patrikpersson/speccyboot/concept.jpg

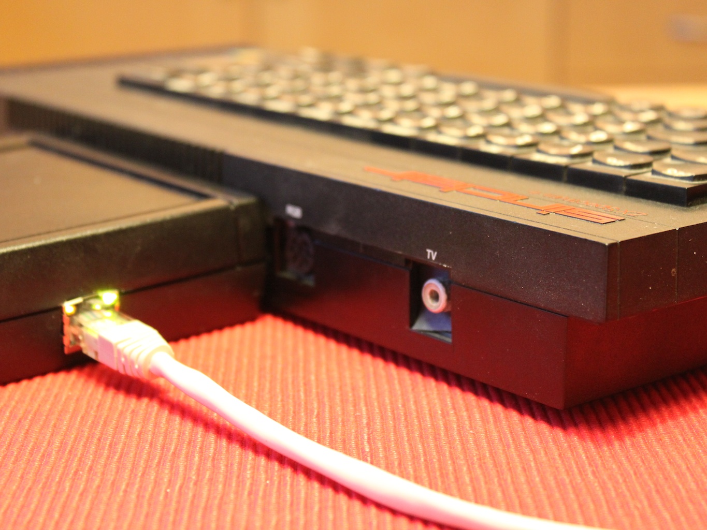
concept.jpg
