patrikpersson/speccyboot/demo-animated.png

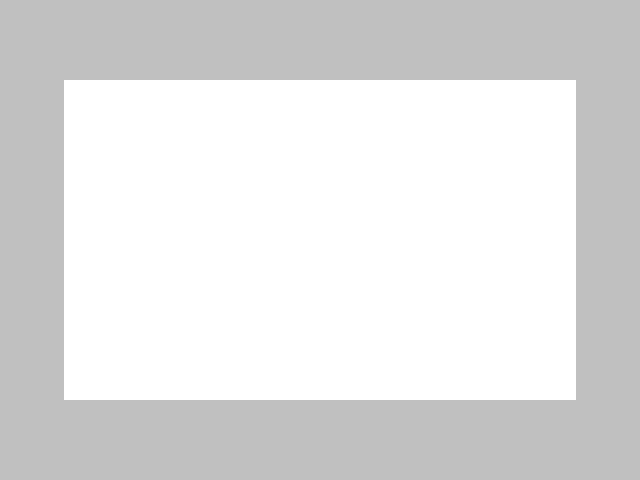
demo-animated.png
