patrikpersson/speccyboot/demo.png

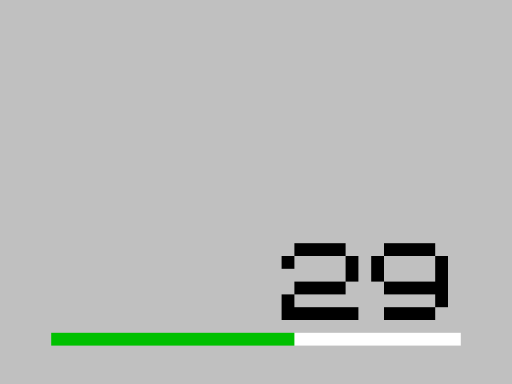
demo.png
