patrikpersson/speccyboot/fuse.png

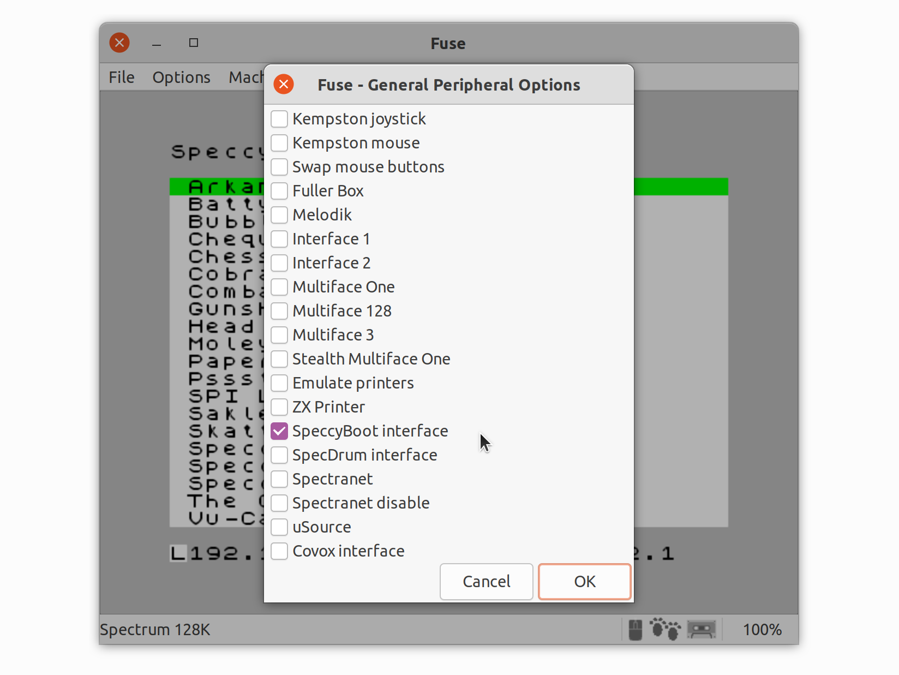
fuse.png
