patrikpersson/speccyboot/hardware.png

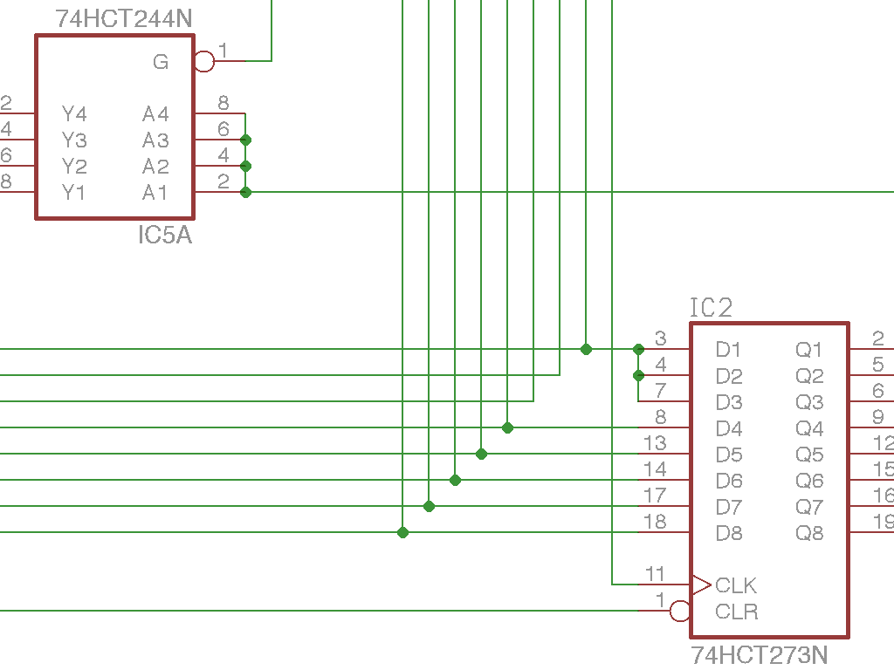
hardware.png
