patrikpersson/speccyboot/schematic.png

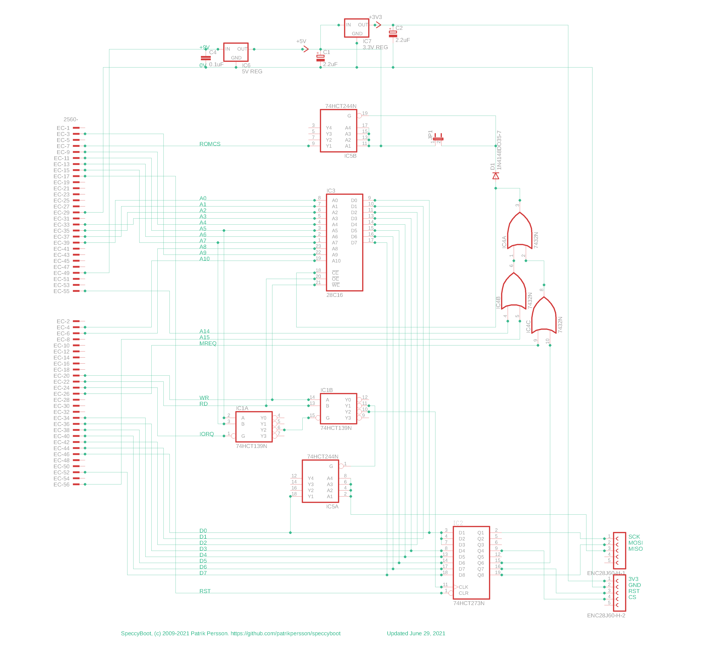
schematic.png
