patrikpersson/speccyboot/speccyboot.sch

## EAGLE design speccyboot.sch (2021-06-29)

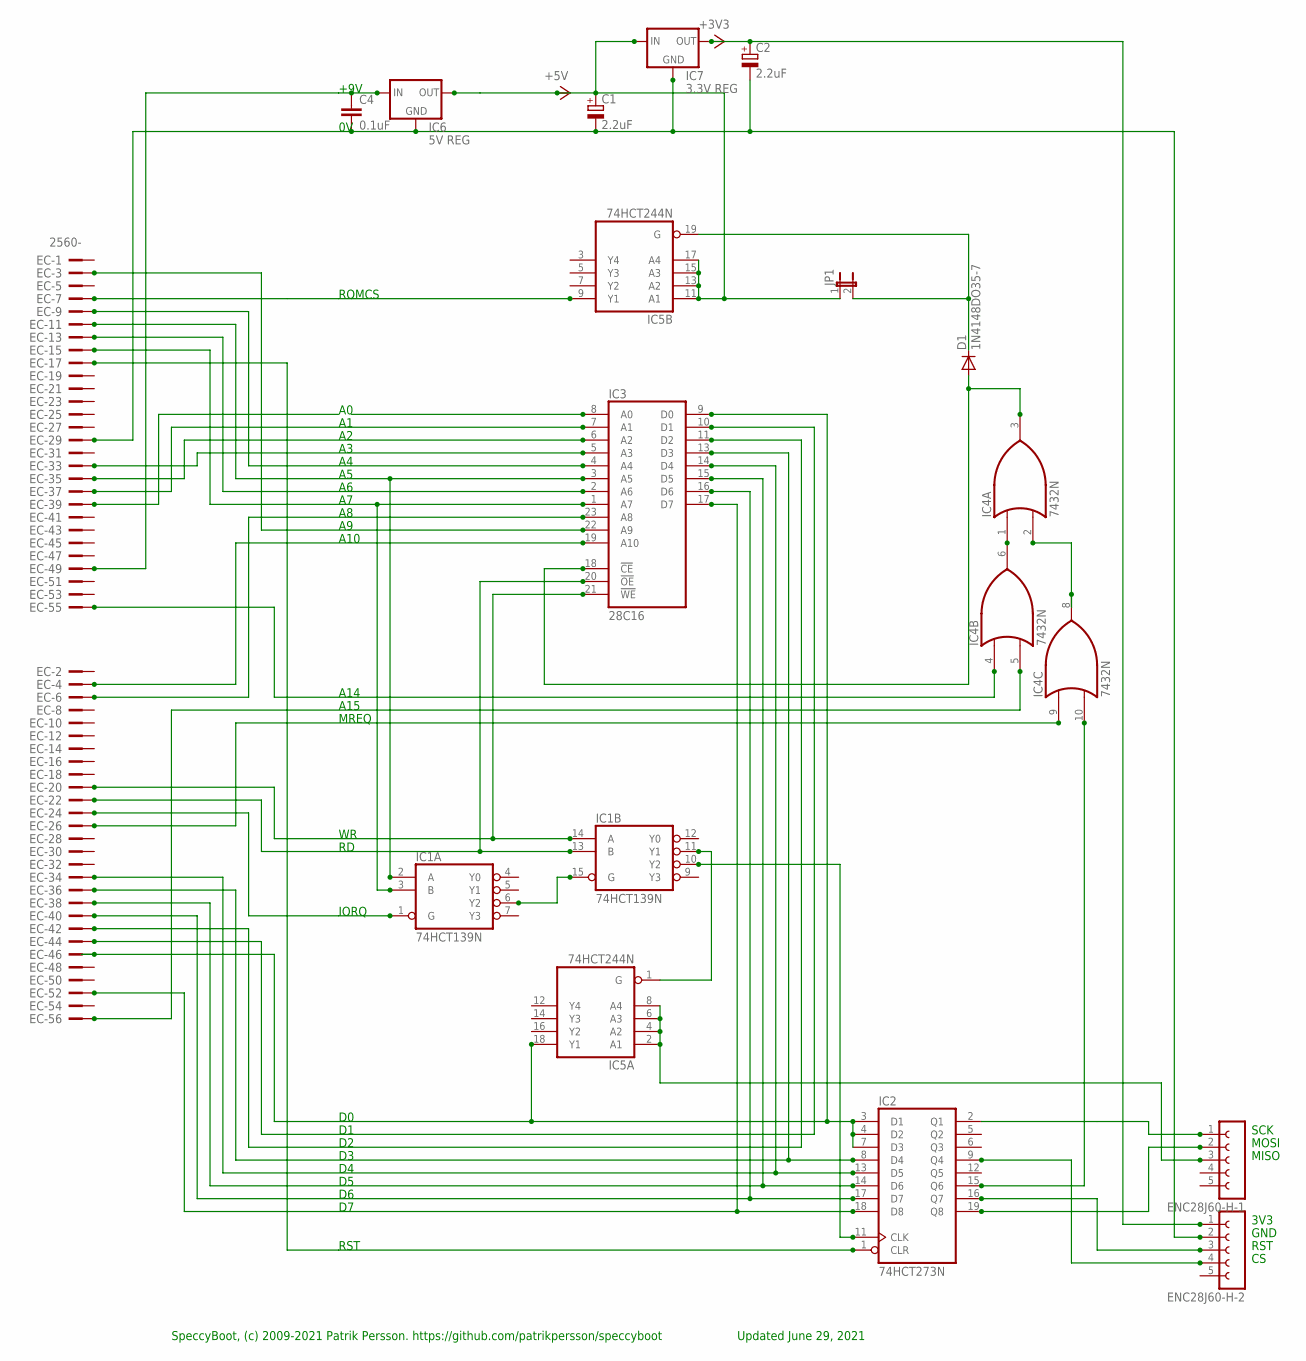
[picture p9: schematic speccyboot.sch]

Parts:
C1, C2: 2.2uF; E1,8-4
C4: 0.1uF; C025-024X044
D1: 1N4148DO35-7; DO35-7
EC: 2560-; PAK100/2500-60
ENC28J60-H-1, ENC28J60-H-2: FE05-1
IC1: 74HCT139N; DIL16
IC2: 74HCT273N; DIL20
IC3: 28C16; DIL24
IC4: 7432N; DIL14
IC5: 74HCT244N; DIL20
IC6: 5V REG; 78XXL
IC7: 3.3V REG; 78XXL
JP1: JP1E; JP1

Connections:
+3V3: C2.+, ENC28J60-H-2.1, IC7.OUT
unnamed: D1.A, IC3.18 (!CE), IC4.3 (O)
unnamed: EC.17, IC2.1 (CLR)
unnamed: EC.52, IC2.18 (D8), IC3.17 (D7), IC4.8 (O)
unnamed: ENC28J60-H-1.3, IC5.2 (A1), IC5.4 (A2), IC5.6 (A3), IC5.8 (A4)
unnamed: EC.38, IC2.14 (D6), IC3.15 (D5)
unnamed: EC.34, IC2.13 (D5), IC3.14 (D4)
unnamed: EC.36, IC2.8 (D4), IC3.13 (D3)
unnamed: EC.40, IC2.17 (D7), IC3.16 (D6)
unnamed: EC.24, IC1.1 (G)
unnamed: EC.46, IC2.3 (D1), IC2.4 (D2), IC2.7 (D3), IC3.9 (D0), IC5.18 (Y1)
unnamed: IC1.10 (Y2), IC2.11 (CLK)
unnamed: ENC28J60-H-2.4, IC2.9 (Q4)
unnamed: ENC28J60-H-2.3, IC2.16 (Q7)
unnamed: EC.42, IC3.11 (D2)
unnamed: EC.44, IC3.10 (D1)
unnamed: EC.37, IC3.7 (A1)
unnamed: EC.35, IC3.6 (A2)
unnamed: EC.33, IC3.5 (A3)
unnamed: EC.9, IC3.4 (A4)
unnamed: EC.11, IC1.2 (A), IC3.3 (A5)
unnamed: EC.13, IC3.2 (A6)
unnamed: EC.15, IC1.3 (B), IC3.1 (A7)
unnamed: EC.6, IC3.23 (A8)
unnamed: EC.3, IC3.22 (A9)
unnamed: EC.4, IC3.19 (A10)
unnamed: ENC28J60-H-1.1, IC2.2 (Q1)
unnamed: ENC28J60-H-1.2, IC2.19 (Q8)
unnamed: C1.-, C2.-, C4.2, EC.29, ENC28J60-H-2.2, IC6.GND, IC7.GND
unnamed: IC1.6 (Y2), IC1.15 (G)
unnamed: EC.7, IC5.9 (Y1)
unnamed: D1.C, IC5.19 (G), JP1.2
unnamed: EC.20, IC1.14 (A), IC3.21 (!WE)
unnamed: IC1.11 (Y1), IC5.1 (G)
unnamed: C4.1, EC.49, IC6.IN
unnamed: EC.26, IC4.9 (I0)
unnamed: EC.55, IC4.4 (I0)
unnamed: IC4.1 (I0), IC4.6 (O)
unnamed: EC.56, IC4.5 (I1)
unnamed: IC2.15 (Q6), IC4.10 (I1)
unnamed: C1.+, IC5.11 (A1), IC5.13 (A2), IC5.15 (A3), IC5.17 (A4), IC7.IN, JP1.1
unnamed: EC.22, IC1.13 (B), IC3.20 (!OE)

Notes on the sheet:
RST
IORQ
A10
+9V
A14
A15
MREQ
ROMCS
SpeccyBoot, (c) 2009-2021 Patrik Persson. https://github.com/patrikpersson/speccyboot
MISO
MOSI
SCK
3V3
GND
Updated June 29, 2021
