patrikpersson/speccyboot/(commit log)

2009-04-07 fixed typos, changed enum to match hardware change
    [speccyboot.h]
2009-04-07 changed hard-wired address
2009-04-07 tuned SPI code, adapted to hardware changes
2009-04-08 fixed typo in license text
    [netboot.h, speccyboot.h]
2009-04-11 fixed speccy 128 init bug; cleaned up SPI code
    [speccyboot.h]
2009-05-02 added test framework
2009-05-31 bugfix: broken F register
    [evacuate.c]
2009-06-01 refactored for target context switch
2009-06-04 almost all registers work in context switch
2009-06-04 faster SPI read
2009-06-04 optimized SPI memory reads for TFTP packets
2009-10-17 more careful checks for current session
2009-10-26 documentation update
    [speccyboot.sch]
2009-10-27 simplified SPI stack
2009-10-29 simplified SPI stack, fixed 128k snapshot bug
2009-11-01 revised context switch to use five camouflaged character cells
2009-11-08 simplified context switch
2009-11-30 added FUSE patch
2009-12-01 documentation update for Fuse patch
2009-12-13 +2A/+3 support (in Fuse)
2010-01-08 8k branch moved to trunk
    [speccyboot.sch]
2010-01-09 temporary check-in for moving branch to trunk
    [speccyboot.sch]
2010-01-09 moved branch back to trunk at rev 116
    [speccyboot.sch]
2010-01-10 moved TFTP outgoing port to 69 (makes for clearer Wireshark output)
2010-01-16 revised schematic
    [speccyboot.sch]
2010-01-16 added check to avoid memory corruption in Fuse
2013-02-28 web update for fuse emulation
2013-03-04 make install copies ROM for FUSE; FUSE patch no longer included
2015-05-03 documentation moved to gh-pages
    [speccyboot.sch]
2015-12-25 fixed bug in schematic; better 74132 symbols
    [speccyboot.sch]
2021-04-04 updated schematics
    [speccyboot.sch]
2021-04-28 date adjusted in schematic
    [speccyboot.sch]
2021-06-29 doc update for version 3
    [speccyboot.sch]
2021-07-11 faster SPI
